karasgit/INDX-for-Voron-2.4/README.md

<b style="color:red;"> After some feedback and own experience, I designed second version of rear mount for Bondtech INDX on Voron 2.4. I recommend to use 42 mm tool distance.   </b>

This repository contains 3d printable models of parts needed to use Bondtech INDX on Voron 2.4 with rear mount 




INDX

This implementation replaces XY joints to be able to mount print head on the rear side of the extrusion. In version 2 there are optimised XY Joint to extend space for X axis. Now there is 352 mm of possible X movement on 350 mm printers.
XY joint - Right

Y end stop switch is moved to front right Z bearing block. The wires are guided to the endstop in the groove of the right gantry extrusion, secured with strips of PET bottle with a width of 11 mm.

Z bearing block


X end stop is on Eddy Probe Mount on the X-carriage. Between X-carriage and smart toolhead is 2 mm spacer. It is designed for better cooling of hotend.

X-carriage

Another alternative is here https://www.printables.com/model/1644881-indx-9mm10mm-belt-mount-for-vorons-standard-belt-p

Tool holder is mounted on original back extrusion (2020). It is adjustable in Z axis +-1.5 mm. The adjust mechanism is designed to eliminate the need of springs(comapre to the version 1). Instead, it uses the pressure of the wrench and gravity to adjust. When adjusting the tools downwards, lightly press the adjustment screw.
On 350 mm printer it is possible to mount max. 8 tools with 36 mm distance (without Bondtech part cooling) or 7 tools with 41 mm distance (with Bondtech part cooling). Bondtech recommend distance 41 mm but surrounding tools are touching part cooling ducts during tool change. For 7 tools it is necessary to have 41 mm distance to fit between A/B drives. I recommend to use 4 or 6 tools with 42 mm distance. 
There is special version for 6 tools on 300 mm printer. It need some cutout on left side of toolholder.
řez

6x42 mm

It is necessary to replace front idlers, because X extrusion have to fit between it. I use https://github.com/selliott79/Other-V2-Idlers .
In my repo are front idlers modified to be able to use original screws. You can use also https://github.com/clee/VoronBFI BFI .

Wires are managed with original X axis cable chain between bottoms rack and back gantry extrusion (form bottom side). Use Z_Chain_mount to mount chain to buttom extrusion. On back gantry extrusion is chain crewed dirctly to extrusion from buttom side. 

Printable area is reduced by 18 mm on Y (332 mm on 350 mm printer)- if you are brave you can reduce only 16 mm:-). X is not reduced and Z without tophead is 300 mm.

I created quick video guide for printer rebuild https://www.youtube.com/watch?v=topIOL-b3Gw

<b> Bill Of Material </b><br>
Here are only additional screws and nuts needed for rebuild of standard Voron 2.4 R2

Front Idlers

M3 Heat Set Insert	2x<br>
M3x16 BHCS(SHCS)	2x<br>
M3 T-nut 		2x<br>

XY Joint

M5x10 BHCS		2x<br>

Tool holder

M3x8 SHCS		4x + 2x per tool<br>
M2 T-nut		4x + 1x per tool<br>
M3 Heat Set Insert	2x + 1x per tool<br>
M3x20 SHCS		2x<br>

X-carriage

M3x8 SHCS		2x<br>
M2x10 Self Tapping	2x<br>
M3x6 FHCS		4x (can be reused form cable chain mount)<br>
M3x16 SHCS		4x<br>
M3 Heat Set Insert	2x<br>
