karasgit/INDX-for-Voron-2.4/pictures/INDX.png

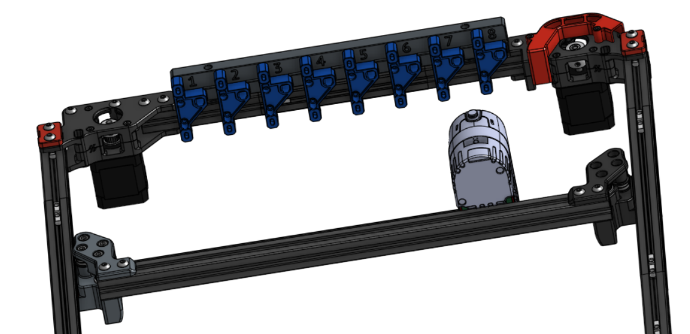
pictures/INDX.png
