karasgit/INDX-for-Voron-2.4/pictures/X-carriage.png

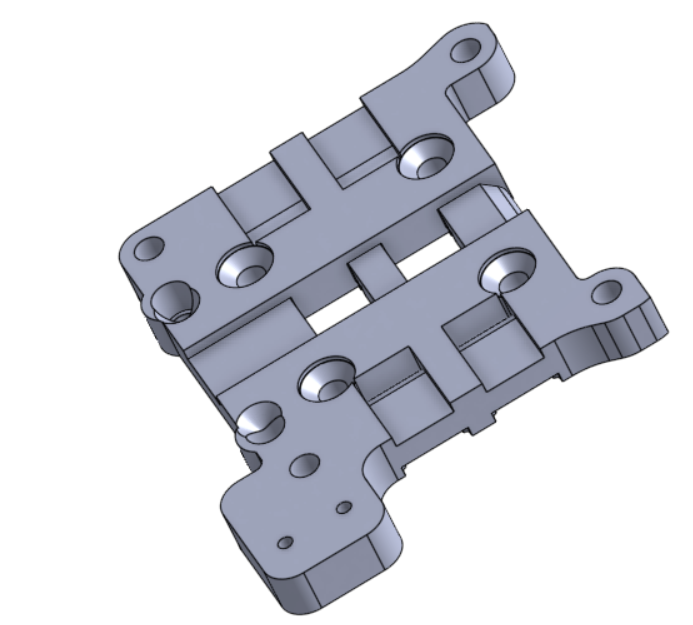
pictures/X-carriage.png
