karasgit/INDX-for-Voron-2.4/pictures/XY joint - Right.png

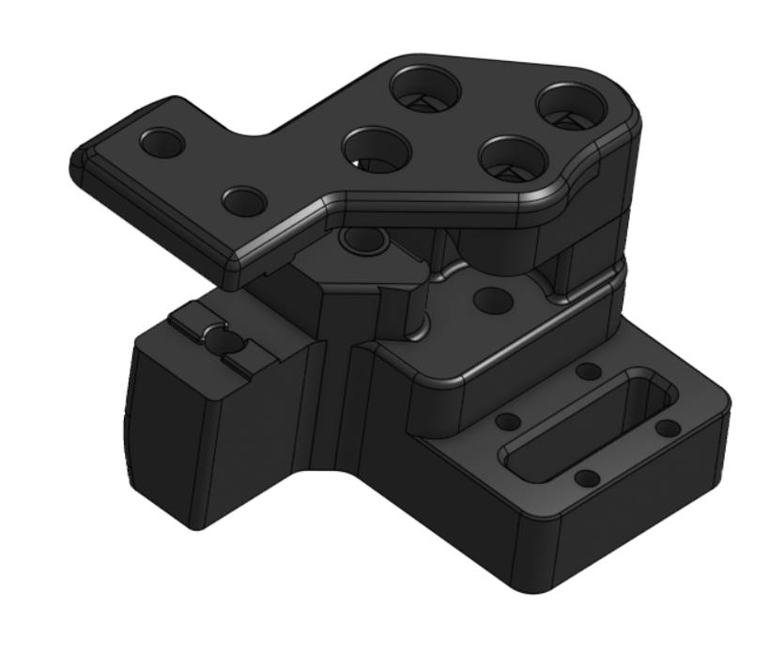
pictures/XY joint - Right.png
