karasgit/INDX-for-Voron-2.4/pictures/Z Bearing block - Y endstop.png

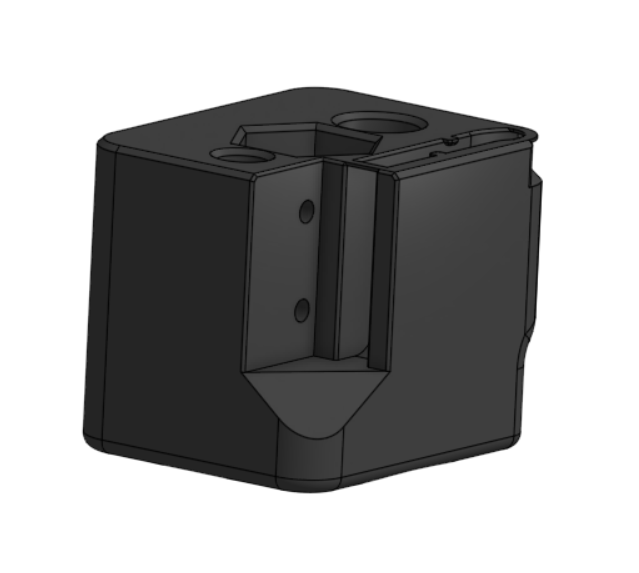
pictures/Z Bearing block - Y endstop.png
