karasgit/INDX-for-Voron-2.4/Front Idlers/[a]_z_belt_clip_x2.stl

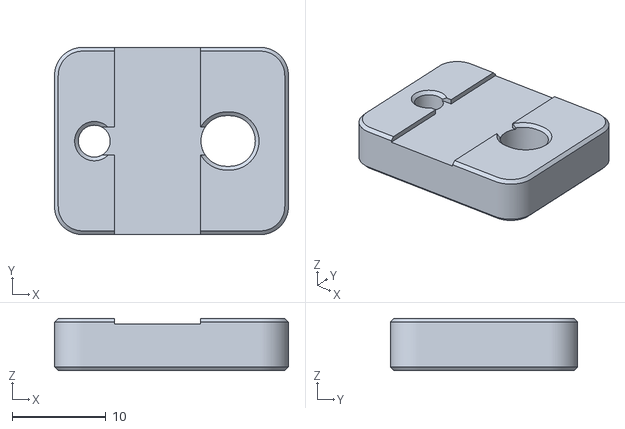
[picture p5: CAD file, 2026-07-27]
Front Idlers/[a]_z_belt_clip_x2.stl
25.0 x 20.0 x 5.60
