karasgit/INDX-for-Voron-2.4/Tool Holder/4 Tools (42 mm)/INDX rear 2020 V2 - INDX Tool Holder 4x42 mm.stl

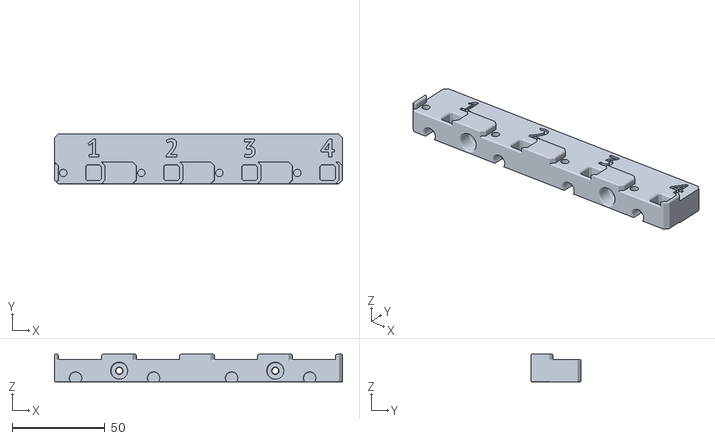
[picture p6: CAD file, 2026-08-26]
Tool Holder/4 Tools (42 mm)/INDX rear 2020 V2 - INDX Tool Holder 4x42 mm.stl
155.0 x 27.0 x 15.0
