karasgit/INDX-for-Voron-2.4/Tool Holder/6 Tools (42 mm)/INDX rear 2020 V2 - INDX Tool Holder 6x42 mm for Voron 2.4 300 mm.stl

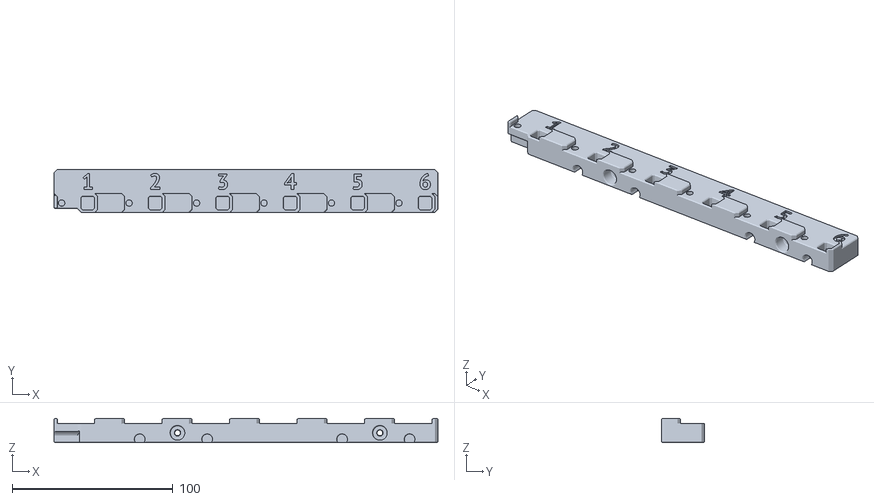
[picture p7: CAD file, 2026-08-28]
Tool Holder/6 Tools (42 mm)/INDX rear 2020 V2 - INDX Tool Holder 6x42 mm for Voron 2.4 300 mm.stl
239.0 x 27.0 x 15.0
