karasgit/INDX-for-Voron-2.4/Tool Holder/7 Tools (41 mm)/INDX rear 2020 V2 - Tool Dock.stl

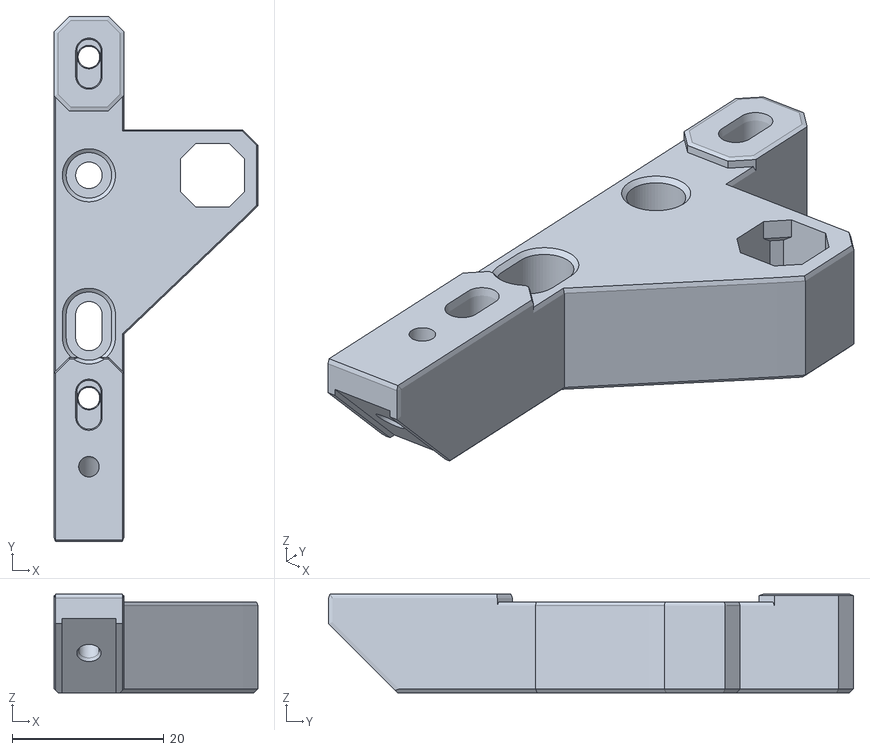
[picture p8: CAD file, 2026-08-26]
Tool Holder/7 Tools (41 mm)/INDX rear 2020 V2 - Tool Dock.stl
26.9 x 69.3 x 13.0
