karasgit/INDX-for-Voron-2.4/Tool Holder/8 Tools (36 mm) - Without Part Cooling/INDX rear 2020 V2 - Adjustment 36 mm.stl

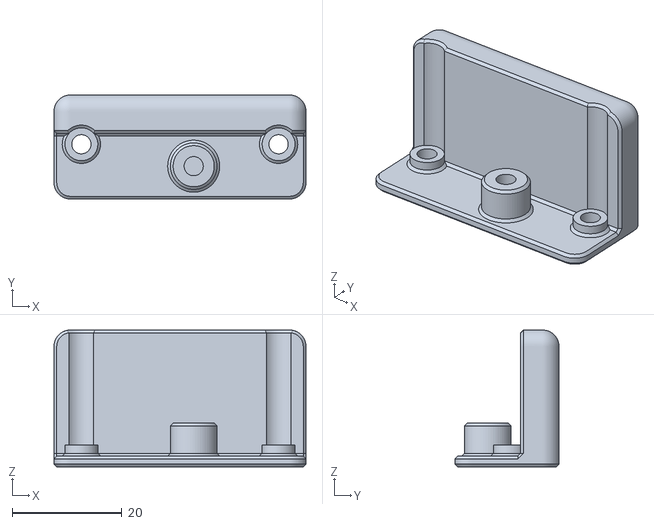
[picture p9: CAD file, 2026-08-26]
Tool Holder/8 Tools (36 mm) - Without Part Cooling/INDX rear 2020 V2 - Adjustment 36 mm.stl
46.0 x 19.0 x 25.0
