karasgit/INDX-for-Voron-2.4/X-carriage/INDX MGN12H - X-carriage spacer.stl

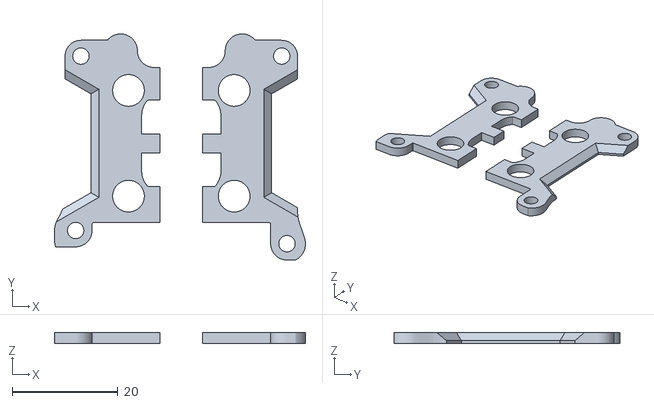
[picture p10: CAD file, 2026-08-26]
X-carriage/INDX MGN12H - X-carriage spacer.stl
47.5 x 42.8 x 2.00
