karasgit/INDX-for-Voron-2.4/XY Joint/XY Joint - Right parts - XY Joint - Right down V2.stl

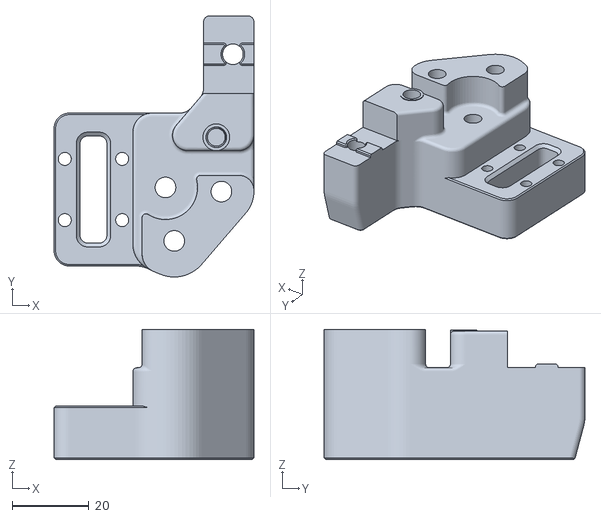
[picture p11: CAD file, 2026-08-26]
XY Joint/XY Joint - Right parts - XY Joint - Right down V2.stl
52.2 x 68.2 x 34.0
