karasgit/INDX-for-Voron-2.4/Z_Chain_Mount/INDX - Z_Chain_Mount.stl

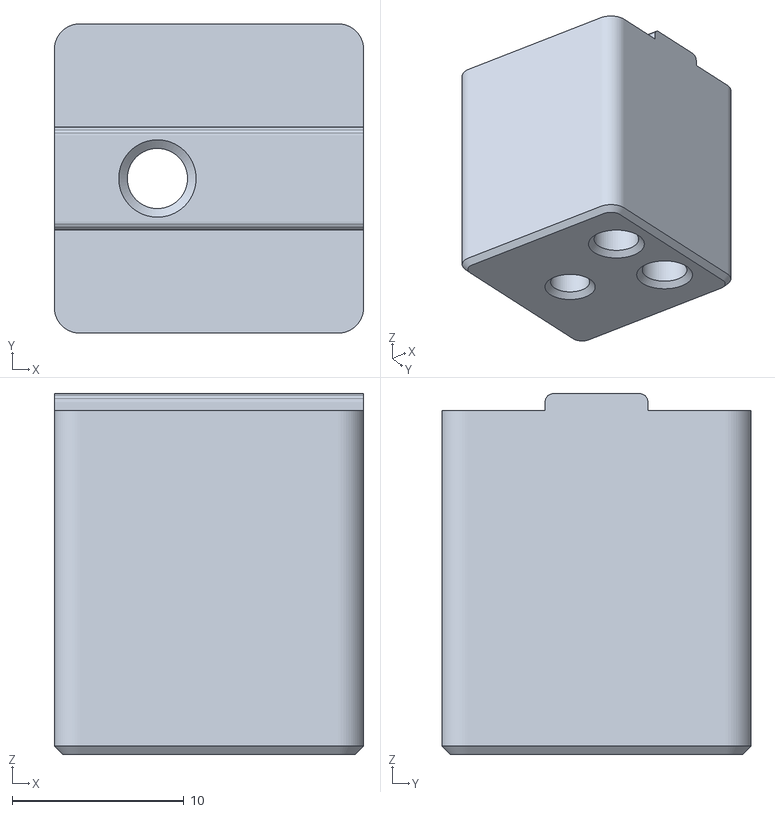
[picture p12: CAD file, 2026-06-16]
Z_Chain_Mount/INDX - Z_Chain_Mount.stl
18.0 x 18.0 x 21.0
