karasgit/INDX-for-Voron-2.4/Front Idlers/Other_Idler_V2 parts - Idler_Carrier Right.stl

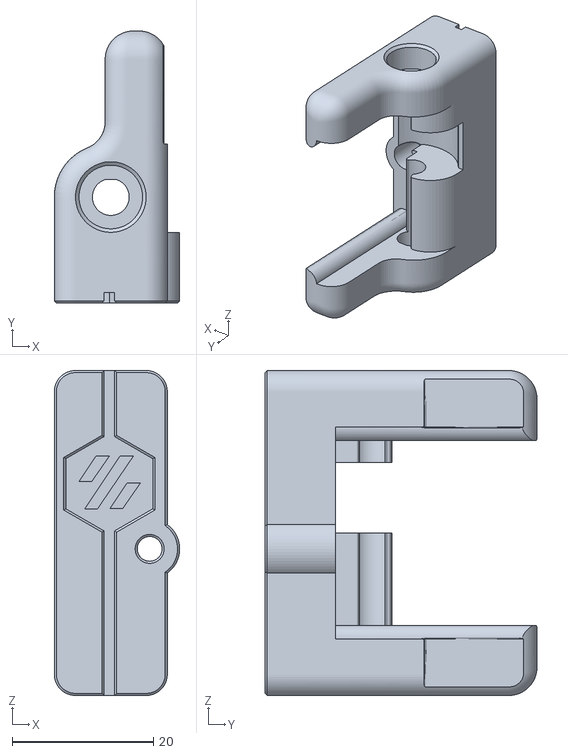
[picture p13: CAD file, 2026-03-20]
Front Idlers/Other_Idler_V2 parts - Idler_Carrier Right.stl
17.8 x 38.5 x 46.0
