karasgit/INDX-for-Voron-2.4/Tool Holder/4 Tools (42 mm)/INDX rear 2020 V2 - Numbers 4x42 mm.stl

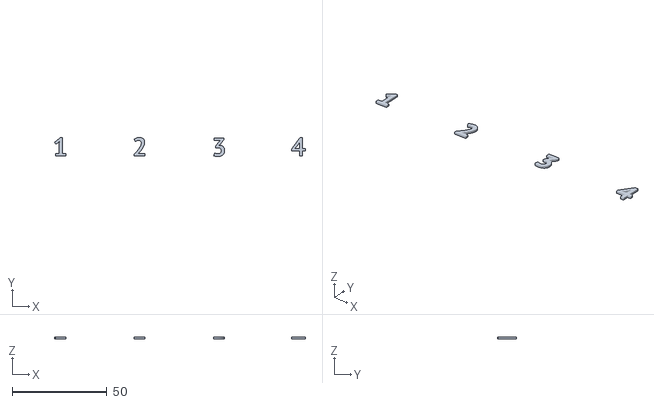
[picture p14: CAD file, 2026-08-26]
Tool Holder/4 Tools (42 mm)/INDX rear 2020 V2 - Numbers 4x42 mm.stl
132.8 x 10.1 x 1.00
