karasgit/INDX-for-Voron-2.4/Tool Holder/6 Tools (42 mm)/INDX rear 2020 V2 - numbers 6 x 42mm.stl

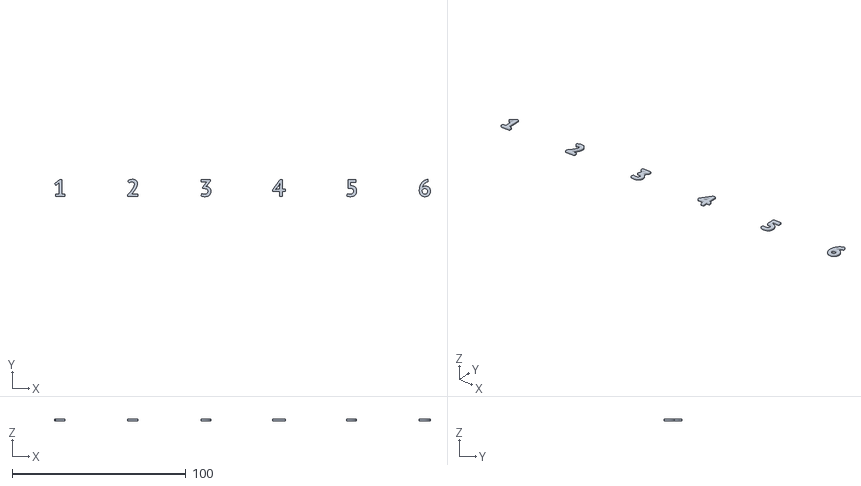
[picture p15: CAD file, 2026-08-26]
Tool Holder/6 Tools (42 mm)/INDX rear 2020 V2 - numbers 6 x 42mm.stl
216.3 x 10.1 x 1.00
