karasgit/INDX-for-Voron-2.4/Tool Holder/7 Tools (41 mm)/INDX rear 2020 V2 - Adjustment 41 mm.stl

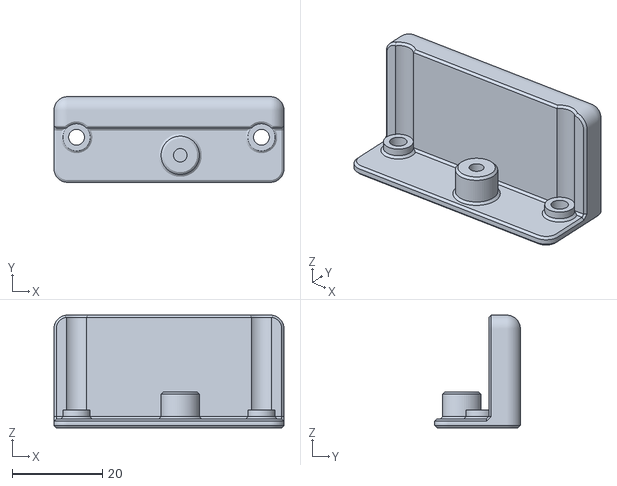
[picture p16: CAD file, 2026-08-26]
Tool Holder/7 Tools (41 mm)/INDX rear 2020 V2 - Adjustment 41 mm.stl
51.0 x 19.0 x 25.0
