karasgit/INDX-for-Voron-2.4/Tool Holder/8 Tools (36 mm) - Without Part Cooling/INDX rear 2020 V2 - Numbers 8x36 mm.stl

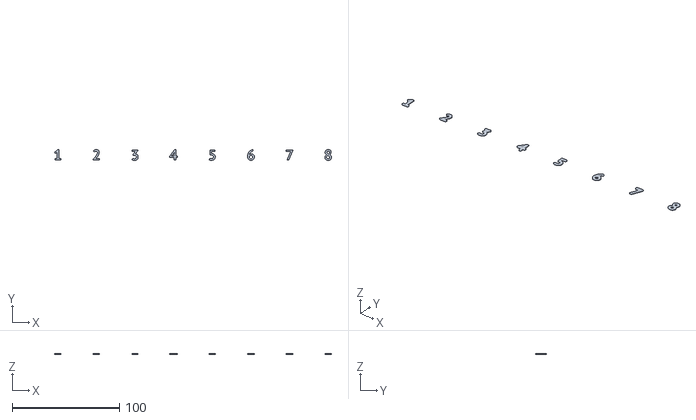
[picture p17: CAD file, 2026-08-26]
Tool Holder/8 Tools (36 mm) - Without Part Cooling/INDX rear 2020 V2 - Numbers 8x36 mm.stl
258.2 x 10.1 x 1.00
