karasgit/INDX-for-Voron-2.4/X-carriage/INDX MGN12H - Beacon Cartographer - X endstop mount V2.stl

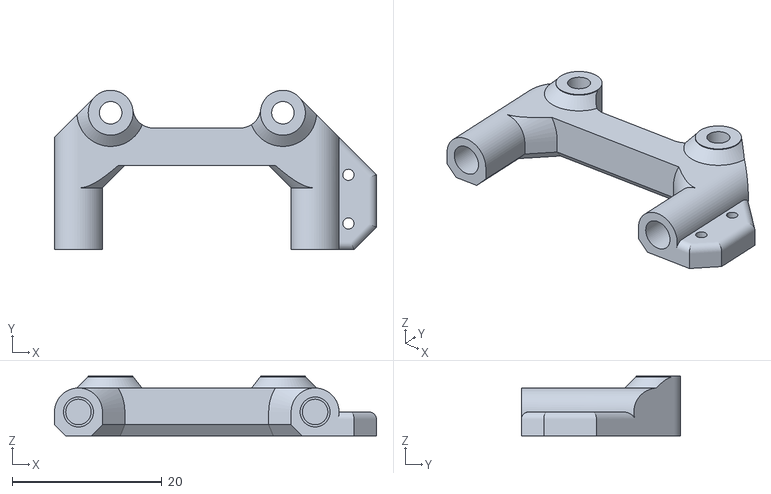
[picture p18: CAD file, 2026-08-26]
X-carriage/INDX MGN12H - Beacon Cartographer - X endstop mount V2.stl
43.0 x 21.3 x 7.99
