karasgit/INDX-for-Voron-2.4/XY Joint/XY Joint - Left parts - XY Joint - Left up V2.stl

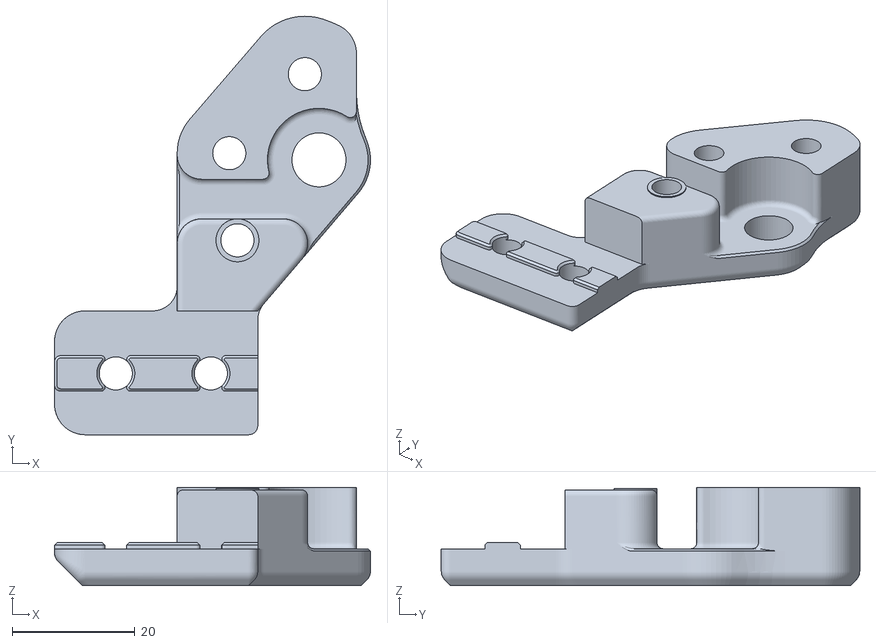
[picture p19: CAD file, 2026-08-26]
XY Joint/XY Joint - Left parts - XY Joint - Left up V2.stl
51.5 x 68.2 x 16.0
