karasgit/INDX-for-Voron-2.4/Z Bearing Block Top Y End Stop/INDX - Z Bearing Block Top Y end stop front mount.stl

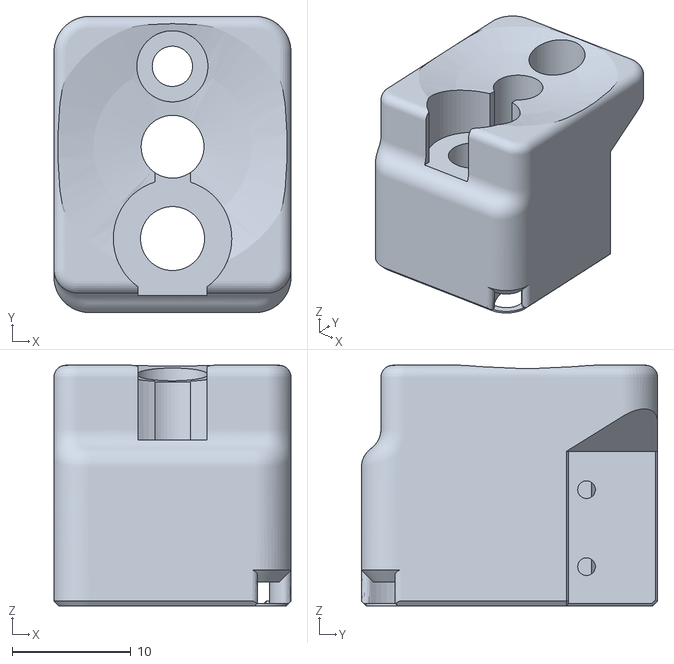
[picture p20: CAD file, 2026-04-19]
Z Bearing Block Top Y End Stop/INDX - Z Bearing Block Top Y end stop front mount.stl
20.0 x 25.0 x 20.3
