karasgit/INDX-for-Voron-2.4/Tool Holder/6 Tools (42 mm)/INDX rear 2020 V2 - Adjustment 42mm.stl

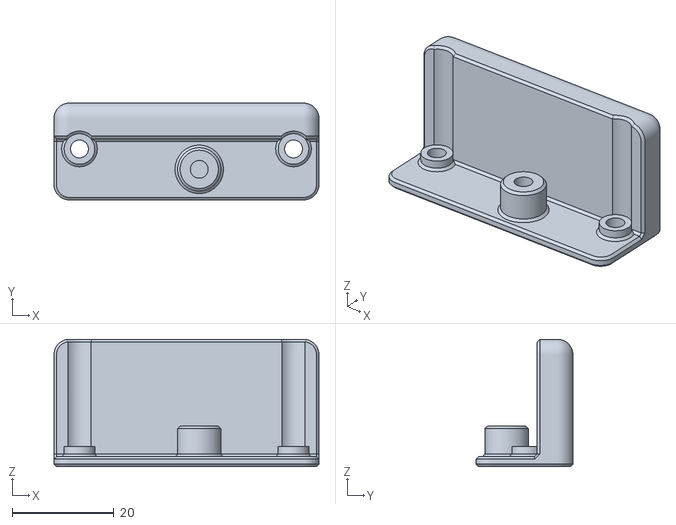
[picture p22: CAD file, 2026-08-26]
Tool Holder/6 Tools (42 mm)/INDX rear 2020 V2 - Adjustment 42mm.stl
52.0 x 19.0 x 25.0
