karasgit/INDX-for-Voron-2.4/Tool Holder/7 Tools (41 mm)/INDX rear 2020 V2 - numbers 7x41 mm .stl

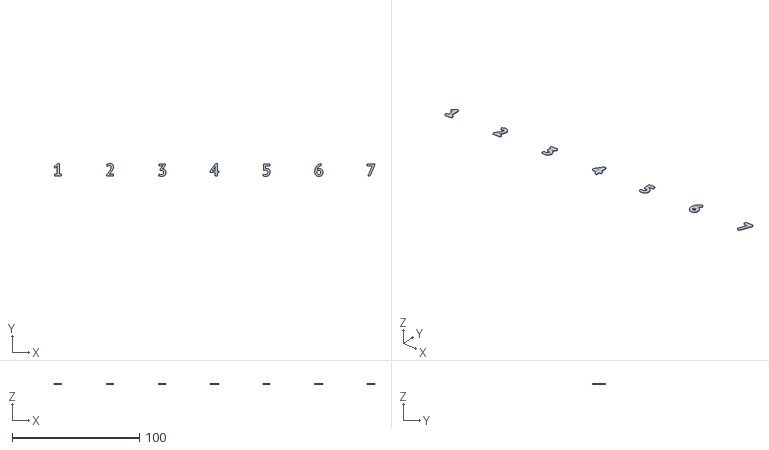
[picture p23: CAD file, 2026-08-26]
Tool Holder/7 Tools (41 mm)/INDX rear 2020 V2 - numbers 7x41 mm .stl
252.2 x 10.1 x 1.00
