karasgit/INDX-for-Voron-2.4/X-carriage/INDX MGN12H - X-carriage.stl

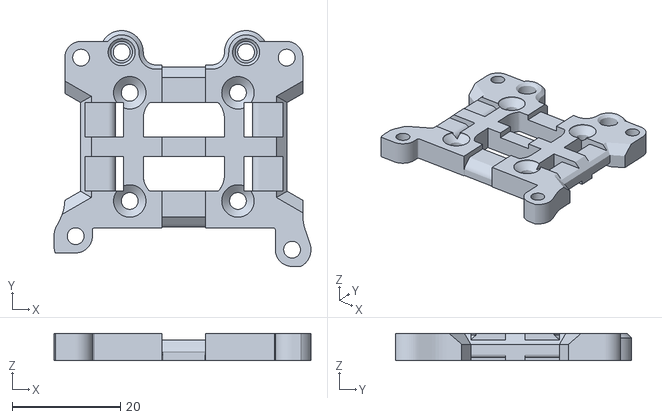
[picture p24: CAD file, 2026-08-26]
X-carriage/INDX MGN12H - X-carriage.stl
47.5 x 43.6 x 5.00
