karasgit/INDX-for-Voron-2.4/Tool Holder/7 Tools (41 mm)/INDX rear 2020 V2 - INDX Tool Holder 7x41 mm.stl

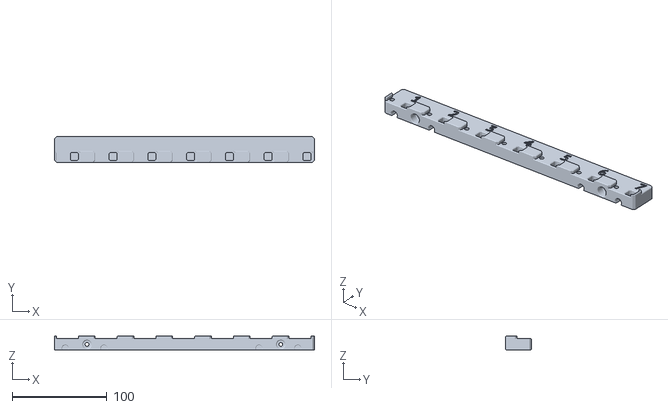
[picture p26: CAD file, 2026-08-26]
Tool Holder/7 Tools (41 mm)/INDX rear 2020 V2 - INDX Tool Holder 7x41 mm.stl
275.0 x 27.0 x 15.0
