karasgit/INDX-for-Voron-2.4/Tool Holder/8 Tools (36 mm) - Without Part Cooling/INDX rear 2020 V2 - INDX Tool Holder 8x36 mm.stl

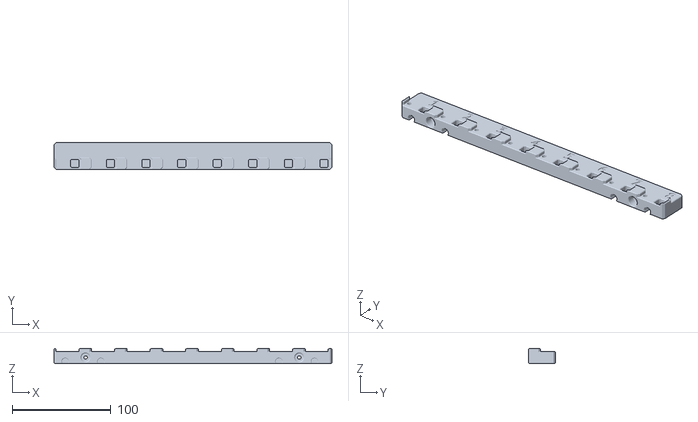
[picture p27: CAD file, 2026-08-26]
Tool Holder/8 Tools (36 mm) - Without Part Cooling/INDX rear 2020 V2 - INDX Tool Holder 8x36 mm.stl
281.0 x 27.0 x 15.0
