karasgit/INDX-for-Voron-2.4/XY Joint/XY Joint - Left parts - XY Joint - Left down V2.stl

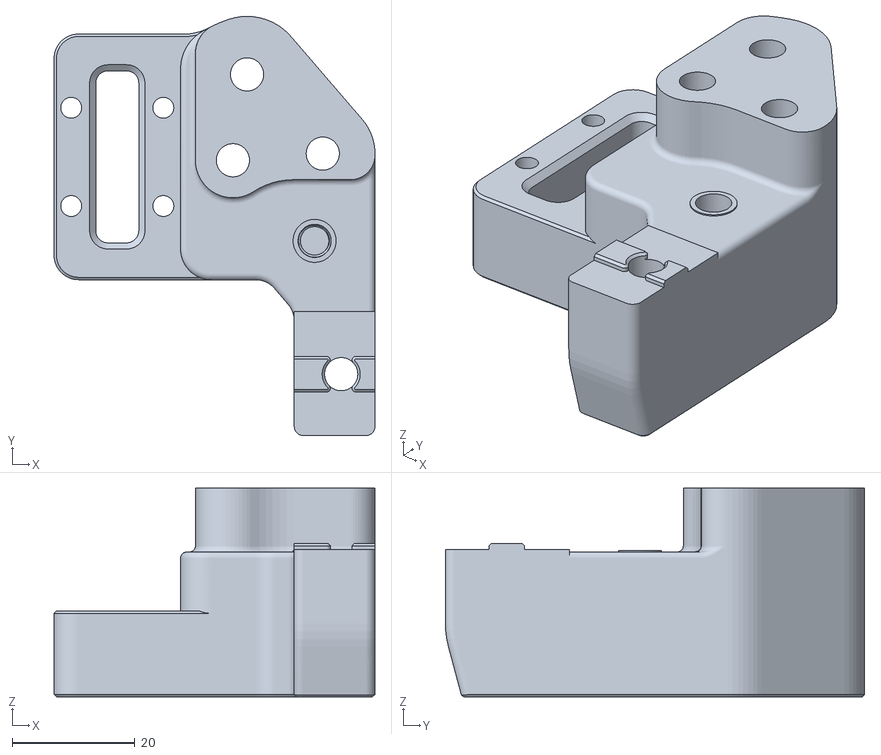
[picture p28: CAD file, 2026-08-26]
XY Joint/XY Joint - Left parts - XY Joint - Left down V2.stl
52.3 x 68.2 x 34.0
