karasgit/INDX-for-Voron-2.4/Front Idlers/Other_Idler_V2 parts - Front Idler Bottom.stl

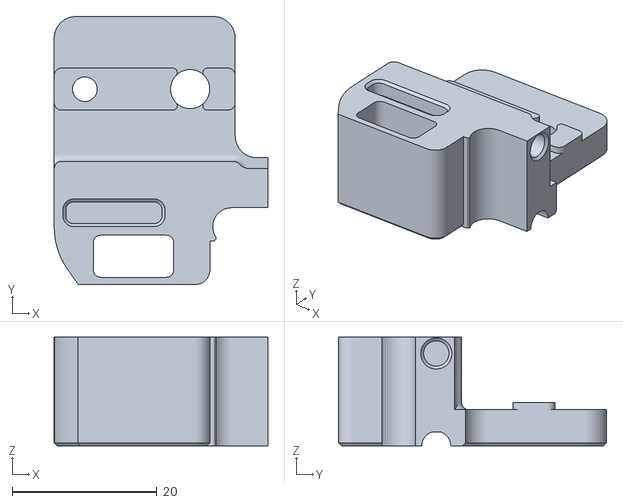
[picture p29: CAD file, 2026-03-20]
Front Idlers/Other_Idler_V2 parts - Front Idler Bottom.stl
29.5 x 37.0 x 15.0
