karasgit/INDX-for-Voron-2.4/Tool Holder/4 Tools (42 mm)/INDX rear 2020 V2 - Tool Dock Magnet holder.STL

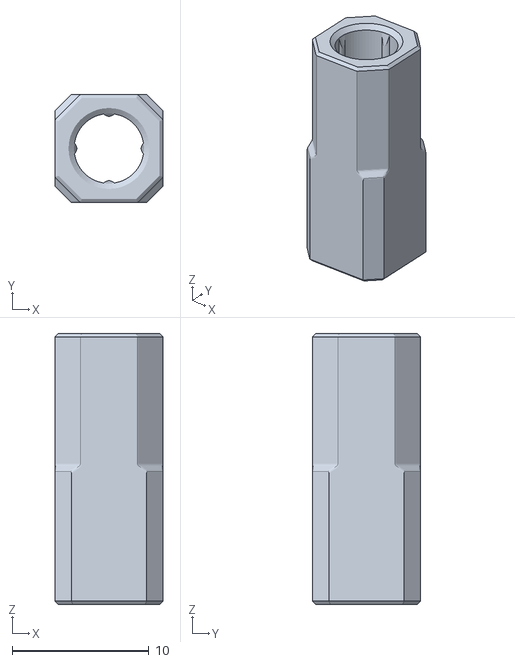
[picture p30: CAD file, 2026-07-27]
Tool Holder/4 Tools (42 mm)/INDX rear 2020 V2 - Tool Dock Magnet holder.STL
7.90 x 7.90 x 19.8
