karasgit/INDX-for-Voron-2.4/Tool Holder/6 Tools (42 mm)/INDX rear 2020 V2 - INDX Tool Holder 6x42 mm.stl

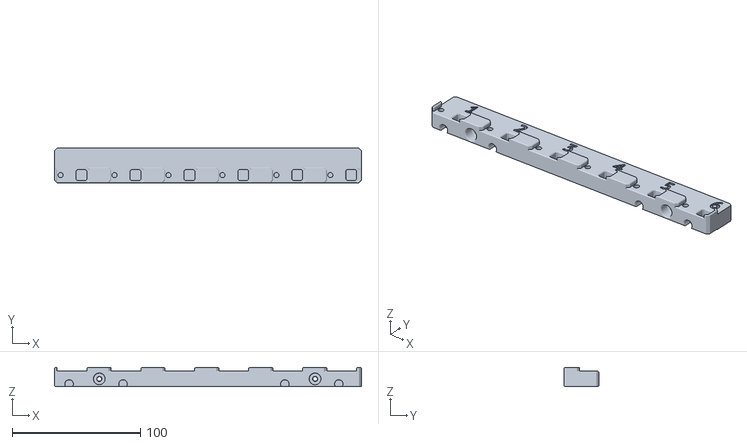
[picture p31: CAD file, 2026-08-26]
Tool Holder/6 Tools (42 mm)/INDX rear 2020 V2 - INDX Tool Holder 6x42 mm.stl
239.0 x 27.0 x 15.0
