karasgit/INDX-for-Voron-2.4/(list of files, cad)

Other CAD files:
Front Idlers/Other_Idler_V2 parts - Idler_Carrier Left.stl
Z Bearing Block Top Y End Stop/INDX - Z Bearing Block Top Y front mount (without screws).stl
